Johns-Hopkins-URC-Mars-Rover/pi3hat/hw/kicadversion/pi3_hat.kicad_pcb

## KiCad design hw/kicadversion/pi3_hat.kicad_pcb (2026-03-08)

Schematic: pi3_hat.kicad_sch

Parts:
+5V0: PAD24AWG_PAD; 24AWG_PAD
C1, C5: .1uF 100V; C0805; MPN 08051C104KAZ2A
C2, C3: 4.7uF 100V; C1206; MPN GRJ31CC72A475KE01K
C4: 0.01uF; C0603; MPN MF-CAP-0603-0.01uF
C6, C14, C23, C29, C37: 10uF; C1206; MPN MF-CAP-1206-10uF
C7, C8: 22uF 16V; C1210; MPN CL32A226KOJNNNE
C9, C10, C12, C13, C15, C16, C17, C18, C19, C21, C22, C24, C25, C26, C27, C28, C30, C31, C32, C33, C35, C36, C38, C39, C40, C41, C42, C43, C44, C45, C46: 0.1uF; C0402; MPN MF-CAP-0402-0.1uF
C11, C20, C34: 1uF; C0402; MPN MF-CAP-0402-1uF
D1, D2, D4, D6: MF-LED-0603-RED; LED0603
D3, D5, D7: MF-LED-0603-RED; LED0603; MPN MF-LED-0603-GREEN
D12: DIODE-DO214AA; DO214AA; MPN SMBJ51A-13-F
F1: MFU0603FF04000P100; FUS_VISHAY_MFU0603; MPN 0686F4000-01
GND0: PAD24AWG_PAD; 24AWG_PAD
I2C0: PINHD-1X4; 1X04; MPN MF-CON-2.54mm-01x04
J1, J2: XT30P; MPN XT30UPB-M
J4: PI3_HEADER2X20-FLIP; 2X20FLIP; MPN PPPC202LFBN-RC
JC1, JC2, JC3, JC4, JC5: JST-PH3SMT_VERT; JST_B3B_PH-SM4-TB(LF)(SN); MPN B3B-PH-SM4-TB(LF)(SN)
JD1, JD2, JD3: JST-ZH6SMT_VERT; JST_B6B-ZR-SM4-TF(LF)(SN); MPN B6B-ZR-SM4-TF(LF)(SN)
JP6: PINHD-1X3; 1X03; MPN MF-CON-2.54mm-01x03
JP7, JP8: PINHD-1X1; 1X01
L1: 10uF; IND_YUDEN_NS10165_YDN; MPN NS10165T100MNA
R1, R15, R16: 4.7k; R0402; MPN MF-RES-0402-4.7K
R2, R21: 105k; R0402; MPN RC0402FR-07105KL
R3: 22.1k; R0402; MPN RC0402FR-0722K1L
R4: 560; R0402; MPN MF-RES-0402-560
R5: 10k 1%; R0603; MPN RC0603FR-0710KL
R6: 53.6k 1%; R0603; MPN RC0603FR-0753K6L
R7, R8, R11, R12, R17, R18: 220; R0402; MPN MF-RES-0402-220
R9, R10, R13, R19, R20: 120; R0402; MPN RC0402FR-07120RL
R14: 1k; R0402; MPN MF-RES-0402-1K
R22, R24: DNP; R0402; MPN MF-RES-0402-0
R23, R25, R26, R27, R28, R29, R30, R31: 0; R0402; MPN MF-RES-0402-0
REGOUT0: PAD24AWG_PAD; 24AWG_PAD
SPI0_CS0, SPI0_MISO0, SPI0_MOSI0, SPI0_SCLK0, SPI1_CS0, SPI1_CS1, SPI1_MISO0, SPI1_MOSI0, SPI1_SCLK0: PAD24AWG_PAD; 24AWG_PAD
U1: MAX17504ATP+T; 21-0140L_T2055-4_MXM; MPN MAX17504ATP+T
U2: DMMT5401; SOT26; MPN DMMT5401-7-F
U3: DMG2305UX; SOT23; MPN AO3415A
U4, U7, U11: STM32G474CEU6; QFN50P700X700X60-49N; MPN STM32G474CEU6
U5, U6, U9, U12, U13: LTC2875; SOIC8; MPN TCAN1057AEVDRQ1‎
U8: BMI088LGA16; LGA16; MPN BMI088
U10: CAT24C32UDFN8; UDFN8_2X3_ONS; MPN CAT24C32HU4I-GT3
U14: ICM-42688-P; PQFN50P300X250X97-14N; MPN ICM-42688-P
UNK3V3_TP0: PAD24AWG_PAD; 24AWG_PAD
UT0: PINHD-1X3; 1X03; MPN MF-CON-2.54mm-01x03
V+0: PAD24AWG_PAD; 24AWG_PAD

Connections:
5VSW: C5.P$2, L1.2, U1.17 (LX_2), U1.18 (LX_3), U1.19 (LX)
+3V3: C10.P$1, C11.P$1, C12.P$1, C13.P$1, C14.P$1, C15.P$1, C19.P$1, C20.P$1, C21.P$1, C22.P$1, C23.P$1, C24.P$1, C27.P$1, C28.P$1, C29.P$1, C30.P$1, C31.P$1, C33.P$1, C34.P$1, C35.P$1, C36.P$1, C37.P$1, C38.P$1, C41.P$1, C42.P$1, I2C0.1, J4.1, J4.17, JD1.6, JD2.6, JD3.6, JP6.2, R7.P$1, R8.P$1, R11.P$1, R12.P$1, R14.P$1, R15.P$1, R16.P$1, R17.P$1, R18.P$1, R22.P$1, R25.P$1, U4.1 (VBAT), U4.20 (VREF+), U4.21 (VDDA), U4.23 (VDD_1), U4.35 (VDD_2), U4.48 (VDD_3), U7.1 (VBAT), U7.3 (PC14-OSC32_IN), U7.20 (VREF+), U7.21 (VDDA), U7.23 (VDD_1), U7.35 (VDD_2), U7.48 (VDD_3), U8.3 (VDD), U8.11 (VDDIO), U10.8 (VCC), U11.1 (VBAT), U11.4 (PC15-OSC32_OUT), U11.20 (VREF+), U11.21 (VDDA), U11.23 (VDD_1), U11.35 (VDD_2), U11.48 (VDD_3), U14.5 (VDDIO), U14.8 (VDD), UNK3V3_TP0.P$1
+5V: +5V0.P$1, J4.2, J4.4, JP6.1, R4.P$1, R23.P$1, U2.6 (E1), U3.3 (D)
AUX_IRQ1: J4.15, U7.17 (PB0)
AUX_IRQ2: J4.16, U7.18 (PB1)
AUX_IRQ3: J4.18, U7.19 (PB2)
CAN_VCC: C26.P$1, C43.P$1, C44.P$1, C45.P$1, C46.P$1, R24.P$1, R25.P$2, U5.5 (SPLIT), U6.5 (SPLIT), U9.5 (SPLIT), U12.5 (SPLIT), U13.5 (SPLIT)
CAN_VIO: J4.38, R26.P$1
FB: R2.P$2, R3.P$1, U1.9 (FB)
GND: C1.P$2, C2.P$2, C3.P$2, C4.P$2, C6.P$2, C7.P$2, C8.P$2, C9.P$2, C10.P$2, C11.P$2, C12.P$2, C13.P$2, C14.P$2, C15.P$2, C16.P$2, C17.P$2, C18.P$2, C19.P$2, C20.P$2, C21.P$2, C22.P$2, C23.P$2, C24.P$2, C25.P$2, C26.P$2, C27.P$2, C28.P$2, C29.P$2, C30.P$2, C31.P$2, C32.P$2, C33.P$2, C34.P$2, C35.P$2, C36.P$2, C37.P$2, C38.P$2, C39.P$2, C40.P$2, C41.P$2, C42.P$2, C43.P$2, C44.P$2, C45.P$2, C46.P$2, D1.CATHODE, D12.A, GND0.P$1, I2C0.4, J1.1, J2.1, J4.6, J4.9, J4.14, J4.20, J4.25, J4.30, J4.34, J4.39, JC1.3, JC2.3, JC3.3, JC4.3, JC5.3, JD1.4, JD2.4, JD3.4, JP6.3, JP7.1, R1.P$2, R3.P$2, R5.P$2, R6.P$2, R24.P$2, U1.13 (SGND), U1.14 (PGND_2), U1.15 (PGND_3), U1.16 (PGND), U1.21 (EPAD), U1.22 (EPAD), U1.23 (EPAD), U1.24 (EPAD), U1.25 (EPAD), U1.26 (EPAD), U1.27 (EPAD), U1.28 (EPAD), U1.29 (EPAD), U1.30 (EPAD), U4.3 (PC14-OSC32_IN), U4.4 (PC15-OSC32_OUT), U4.49 (THERMALPAD), U5.2 (GND), U5.8 (RS), U6.2 (GND), U6.8 (RS), U7.4 (PC15-OSC32_OUT), U7.49 (THERMALPAD), U8.4 (GND), U8.6 (GNDIO), U8.7 (PS), U9.2 (GND), U9.8 (RS), U10.1 (A0), U10.2 (A1), U10.3 (A2), U10.4 (VSS), U11.3 (PC14-OSC32_IN), U11.49 (THERMALPAD), U12.2 (GND), U12.8 (RS), U13.2 (GND), U13.8 (RS), U14.6 (GND), UT0.3
GNDSEP: R1.P$1, R21.P$2, U7.16 (PC4)
I2C1_SCL: I2C0.3, J4.5
I2C1_SDA: I2C0.2, J4.3
ID_SCL: J4.28, R16.P$2, U10.6 (SCL)
ID_SDA: J4.27, R15.P$2, U10.5 (SDA)
IFACEA_IRQ1: J4.37, U4.17 (PB0)
IFACEB_IRQ1: J4.29, U11.17 (PB0)
IMU2_CLKIN: C16.P$1, C17.P$1, C25.P$1, C39.P$1, C40.P$1, R22.P$2, R23.P$2, U5.3 (VCC), U6.3 (VCC), U9.3 (VCC), U12.3 (VCC), U13.3 (VCC)
IMU2_CS: U7.22 (PB10), U14.9 (INT2/FSYNC/CLKIN)
IMU_ACC_INT: U7.32 (PA10), U8.16 (INT1)
IMU_CS1: U7.31 (PA9), U8.14 (CSB1)
IMU_CS2: U7.25 (PB12), U8.5 (CSB2)
IMU_GYRO_INT: U7.30 (PA8), U8.12 (INT3), U14.4 (INT1/INT)
IMU_MISO: U7.27 (PB14), U8.10 (SDO2), U8.15 (SDO1), U14.1 (AP_SDO/AP_AD0)
IMU_MOSI: U7.28 (PB15), U8.9 (SDI), U14.14 (AP_SDA/AP_SDIO/AP_SDI)
IMU_SCK: U7.26 (PB13), U8.8 (SCK), U14.13 (AP_SCL/AP_SCLK)
unnamed: R5.P$1, U2.2 (B1), U2.3 (B2), U2.4 (C2)
unnamed: JC1.1, R9.P$1, U6.7 (CANH)
unnamed: J4.40, R27.P$1
unnamed: JC1.2, R9.P$2, U6.6 (CANL)
unnamed: R6.P$1, U2.1 (C1), U3.1 (G)
unnamed: J4.35, R28.P$2
unnamed: JC2.1, R10.P$1, U5.7 (CANH)
unnamed: JC2.2, R10.P$2, U5.6 (CANL)
unnamed: D1.ANODE, R4.P$2
unnamed: J4.19, R29.P$2
unnamed: U4.33 (PA11), U5.4 (RXD)
unnamed: J4.21, R30.P$2
unnamed: C9.P$1, JD1.2, U4.7 (PG10-NRST)
unnamed: C5.P$1, U1.20 (BST)
unnamed: JD1.3, U4.36 (PA13)
unnamed: JD1.5, U4.37 (PA14)
unnamed: U4.41 (PB3), U6.4 (RXD)
unnamed: U4.42 (PB4), U6.1 (TXD)
unnamed: C4.P$1, U1.7 (SS)
unnamed: J4.23, R31.P$2
unnamed: C6.P$1, U1.12 (VCC)
unnamed: JC3.1, R19.P$1, U12.7 (CANH)
unnamed: JC3.2, R19.P$2, U12.6 (CANL)
unnamed: JC4.1, R20.P$1, U13.7 (CANH)
unnamed: JC4.2, R20.P$2, U13.6 (CANL)
unnamed: D3.ANODE, R8.P$2
unnamed: D3.CATHODE, U4.5 (PF0-OSC_IN)
unnamed: D2.ANODE, R7.P$2
unnamed: D2.CATHODE, U4.6 (PF1-OSC_OUT)
unnamed: C32.P$1, JD2.2, U11.7 (PG10-NRST)
unnamed: JD2.3, U11.36 (PA13)
unnamed: JD2.5, U11.37 (PA14)
unnamed: D7.ANODE, R18.P$2
unnamed: D7.CATHODE, U11.5 (PF0-OSC_IN)
unnamed: D6.ANODE, R17.P$2
unnamed: D6.CATHODE, U11.6 (PF1-OSC_OUT)
unnamed: U11.33 (PA11), U13.4 (RXD)
unnamed: U11.34 (PA12), U13.1 (TXD)
unnamed: U11.41 (PB3), U12.4 (RXD)
unnamed: U11.42 (PB4), U12.1 (TXD)
unnamed: JP8.1, R14.P$2, U10.7 (WP)
unnamed: JC5.1, R13.P$1, U9.7 (CANH)
unnamed: JC5.2, R13.P$2, U9.6 (CANL)
unnamed: C18.P$1, JD3.2, U7.7 (PG10-NRST)
unnamed: JD3.3, U7.36 (PA13)
unnamed: JD3.5, U7.37 (PA14)
unnamed: D5.ANODE, R12.P$2
unnamed: D5.CATHODE, U7.5 (PF0-OSC_IN)
unnamed: D4.ANODE, R11.P$2
unnamed: D4.CATHODE, U7.6 (PF1-OSC_OUT)
unnamed: U7.33 (PA11), U9.4 (RXD)
unnamed: U7.34 (PA12), U9.1 (TXD)
unnamed: U4.34 (PA12), U5.1 (TXD)
PI32: J4.32, UT0.1
PI33: J4.33, UT0.2
PI_RX_3V: J4.10
PI_TX_3V: J4.8
REGOUT: C7.P$1, C8.P$1, L1.1, R2.P$1, REGOUT0.P$1, U2.5 (E2), U3.2 (S)
SPI0_CS0: J4.24, SPI0_CS0.P$1, U7.12 (PA4)
SPI0_CS1: J4.26
SPI0_MISO: R30.P$1, SPI0_MISO0.P$1, U7.14 (PA6)
SPI0_MOSI: R29.P$1, SPI0_MOSI0.P$1, U7.15 (PA7)
SPI0_SCLK: R31.P$1, SPI0_SCLK0.P$1, U7.13 (PA5)
SPI1_CS0: J4.12, SPI1_CS0.P$1, U4.12 (PA4)
SPI1_CS1: J4.11, SPI1_CS1.P$1, U11.12 (PA4)
SPI1_CS2: J4.36
SPI1_MISO: R28.P$1, SPI1_MISO0.P$1, U4.14 (PA6), U11.14 (PA6)
SPI1_MOSI: R26.P$2, SPI1_MOSI0.P$1, U4.15 (PA7), U11.15 (PA7)
SPI1_SCLK: R27.P$2, SPI1_SCLK0.P$1, U4.13 (PA5), U11.13 (PA5)
V+: F1.1, J1.2, J2.2, R21.P$1, V+0.P$1
V+FUSED: C1.P$1, C2.P$1, C3.P$1, D12.C, F1.2, U1.1 (VIN_2), U1.2 (VIN_3), U1.3 (VIN), U1.4 (EN/UVLO)
V+SENSE: U7.24 (PB11), U14.12 (AP_CS)

Notes on the sheet:
RPI HEADER
IFACE B
AUX / IMU
DEVICE 0x0 (00)
mjbots pi3 hat r4.5 (c) 2022 mjbots Robotic Systems Licensed under the Apache 2.0 License
TEST POINTS
IFACE A
DEVICE 0x1 (01)
DEVICE 0x2 (10)
INPUT POWER

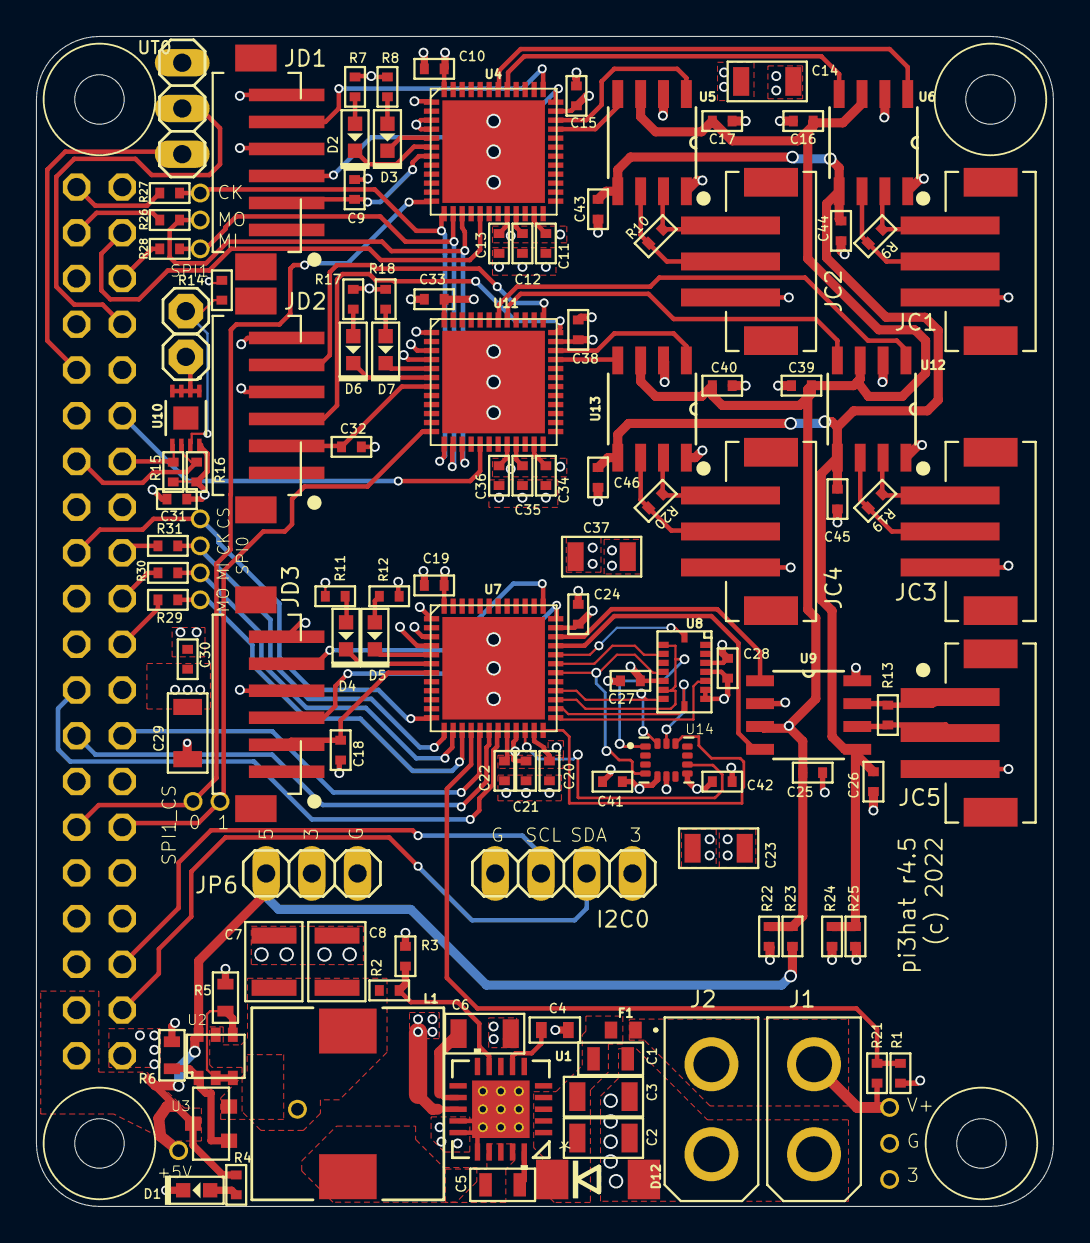
[picture p1: board pi3_hat.kicad_pcb from above]

Board: 4 copper layers, 56.5 x 65.0 mm, 135 parts (1 on the bottom side), 94 nets.

Other parts of the board:
@HOLE0, @HOLE1, @HOLE2, @HOLE3: (no value)
